AleksaHeler/Constant-current-load/README.md

# Constant-current-load
Constant current load circuit with 0-2A adjustment

## Finding a design and adjusting it
For some time I was looking to make a constant current loads to test some pc power supplies I converted to bench power supplies. I found some designs but had various results and nothing seemed to be stable and reliable enough. The main problem was usually the initial current surge was too high and power supplies considered it a short circuit and switched off. Another obstacle was I didn't have an oscilloscope, but I recently got one [JYETech DSO150 Digital Oscilloscope](https://www.banggood.com/Original-JYETech-Assembled-DSO-SHELL-DSO150-Digital-Oscilloscope-Module-9V-p-1211151.html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). Also I came across this thread and this reply on [eevblog.com](https://www.eevblog.com/forum/beginners/a-load-off-my-mnd/msg2151265/#msg2151265), and it seemed promising:
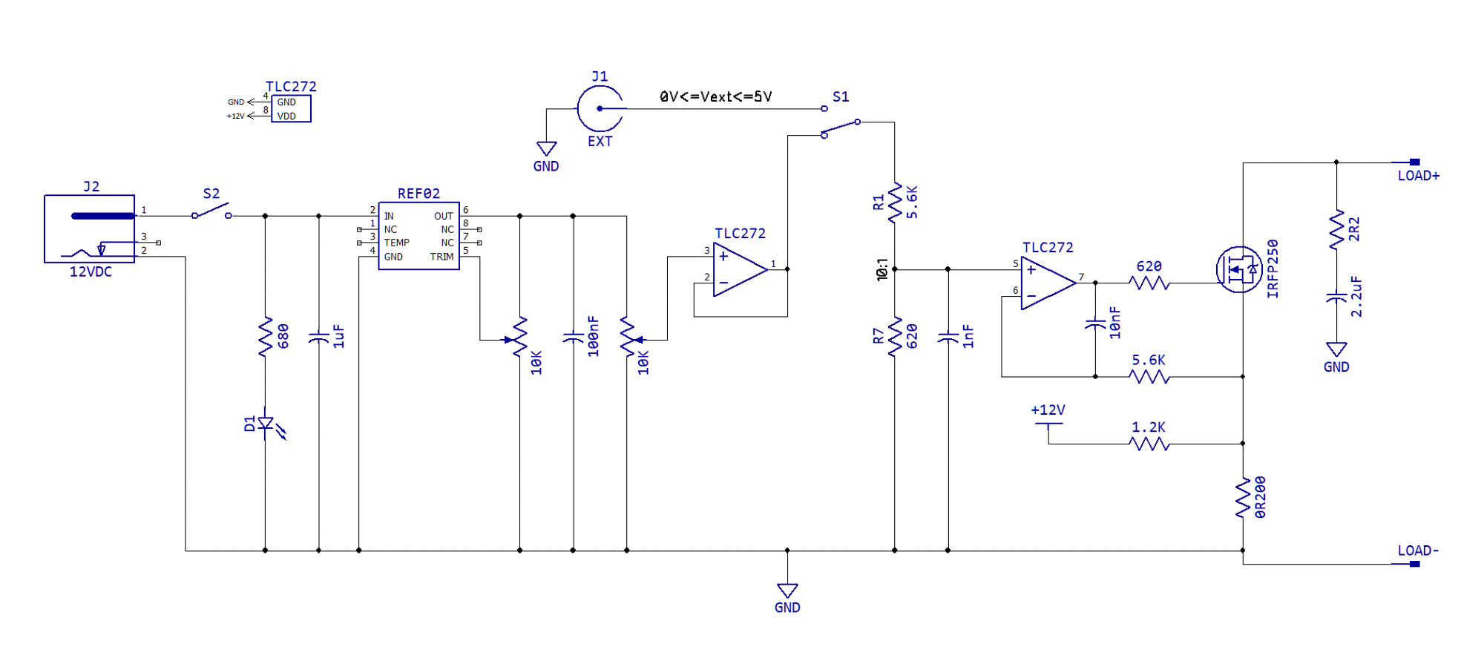
[picture p1: images/eevblog_schematic.jpg]
<br>  
<br> So i changed some things on this schematic to adjust to components I already had and got this:
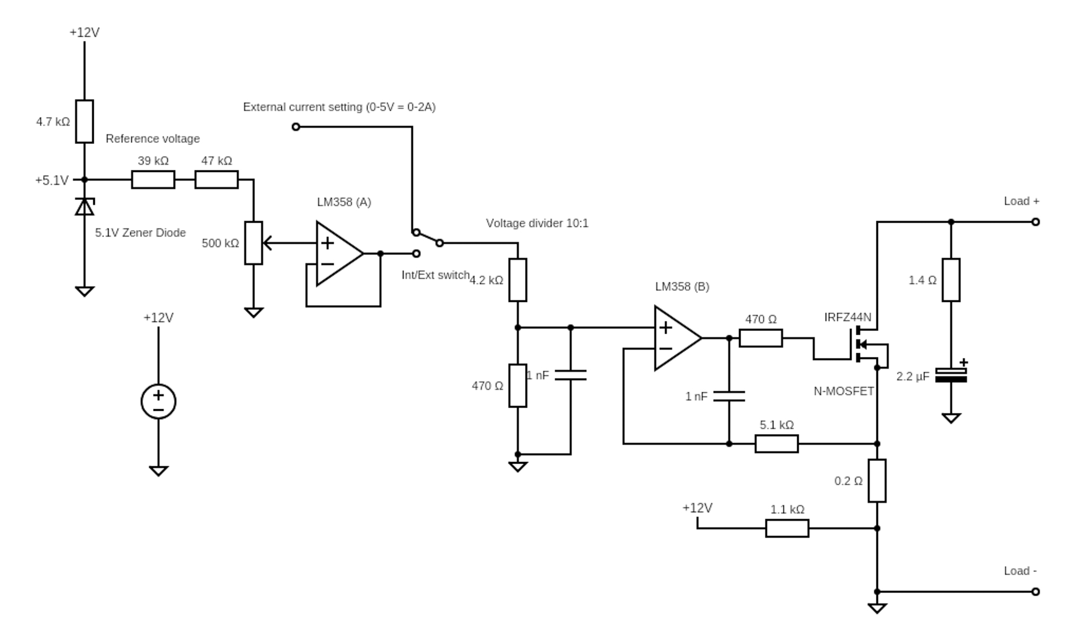
[picture p2: images/my_schematic.jpg]
<br>  

## Prototype and testing
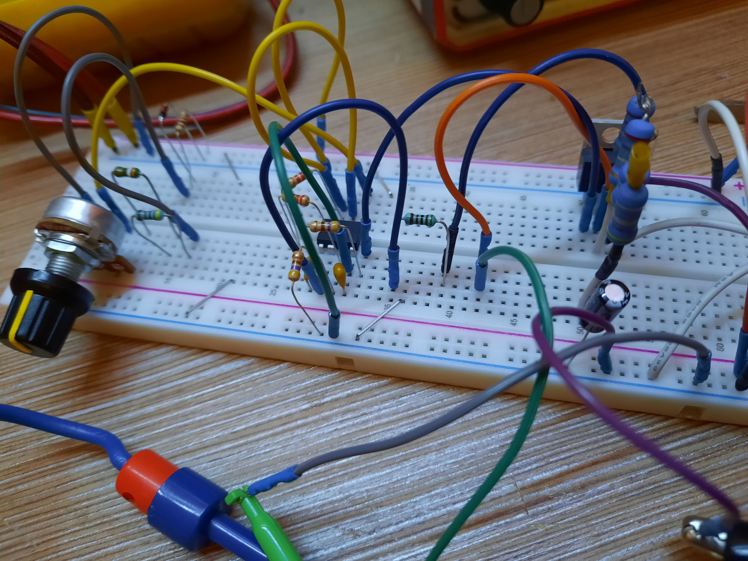
[picture p3: images/breadboard.jpg]
After I got the circuit planed out I started to assemble it all on a breadboard 
<br> Not much to say here but to show some pictures:
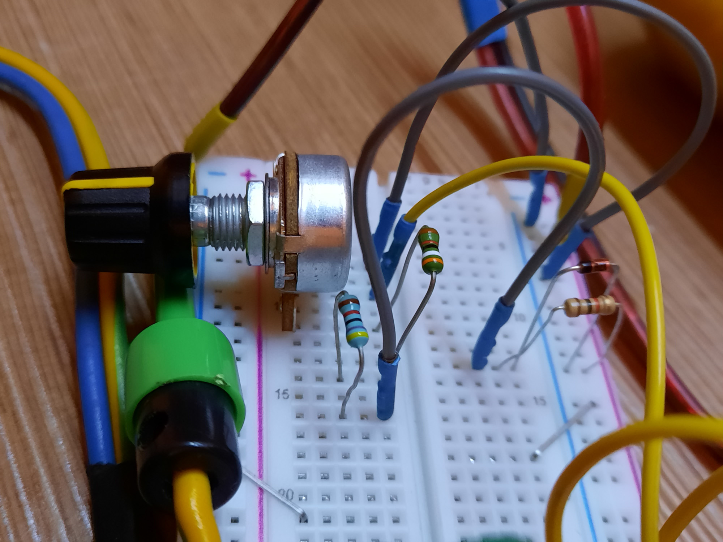
[picture p4: images/breadboard_pot.jpg]
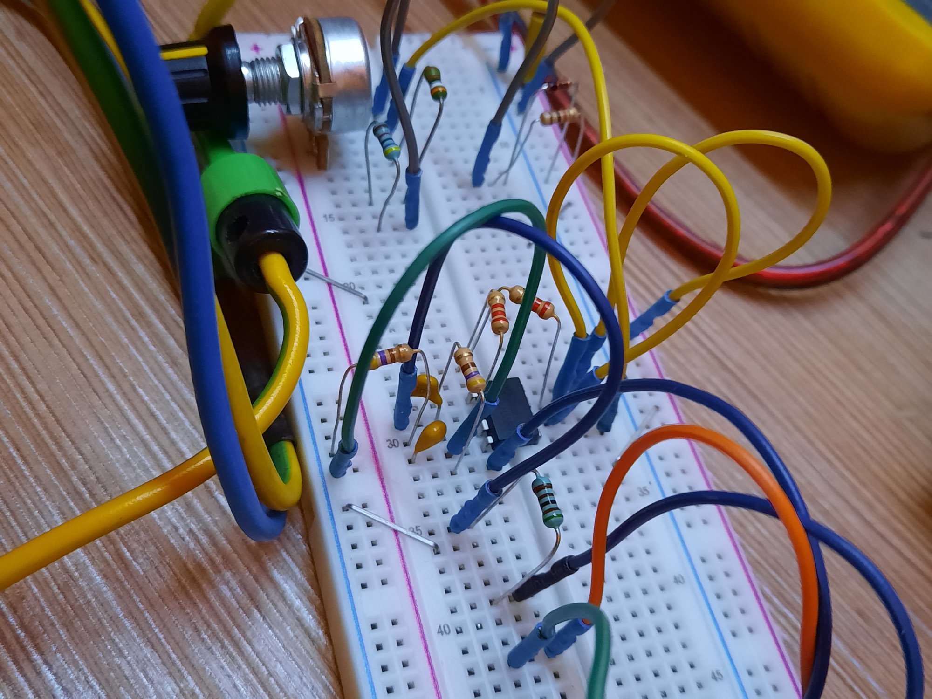
[picture p5: images/breadboard_opamp.jpg]
<br> 
<br> Next step was testing, and I tested how much power does the circuit consume, and it was about 20mA at 12V which is 0.24W both while idle and while sinking a 1A load on 5V.
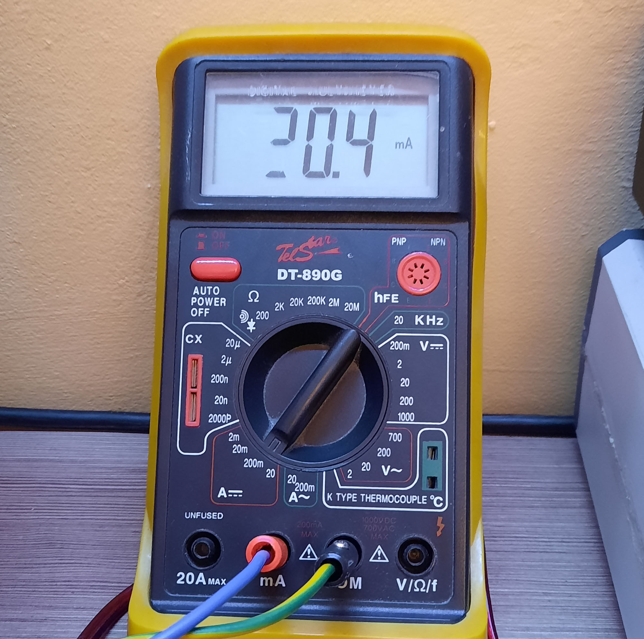
[picture p6: images/meter_idle.jpg]
<br> 
<br> Another thing I tested is will the current be same at different voltages, and it was 0.25A both on 5V and on 12V without changing anything else.
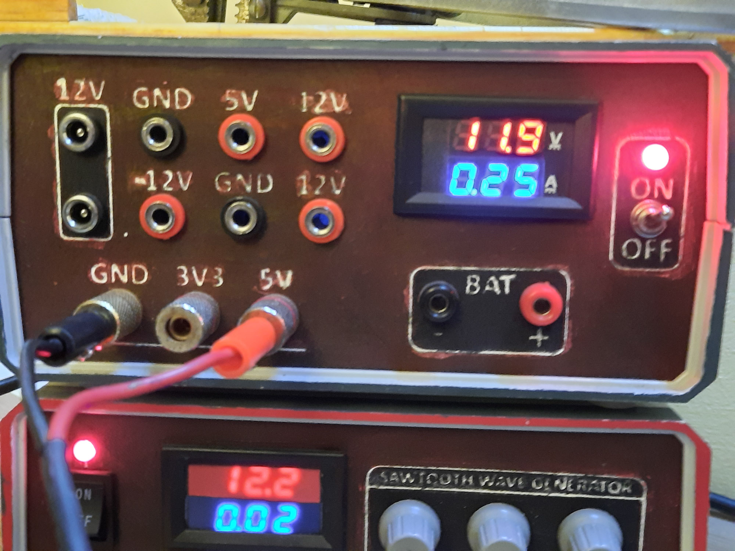
[picture p7: images/load_5V_0.25A.jpg]
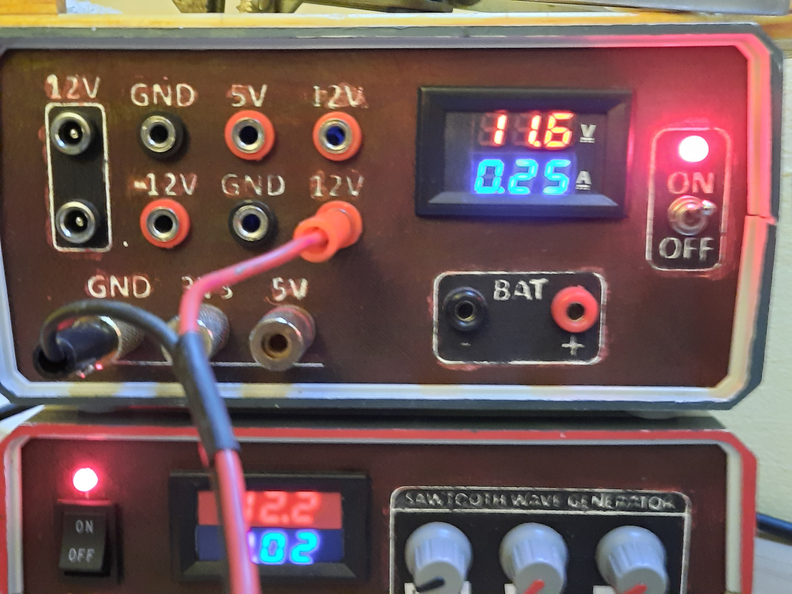
[picture p8: images/load_12V_0.25A.jpg]
<br>  
<br> Final thing, which I was most worried about was initial current surge. The 1nF capacitor on output of second opamp is to prevent that spike, and after testing with 1nF, 10nf and 100nF caps I found the 1nF worked the best and kept it.
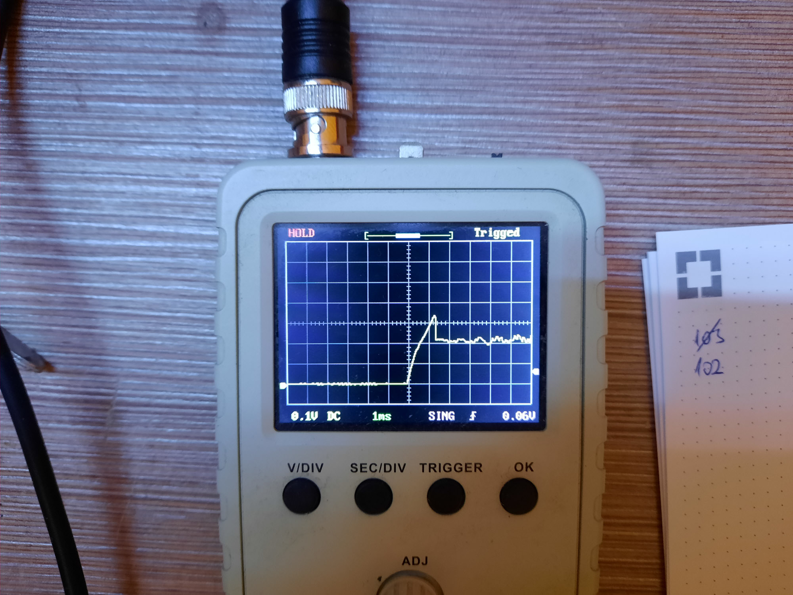
[picture p9: images/osc_cap_102.jpg]
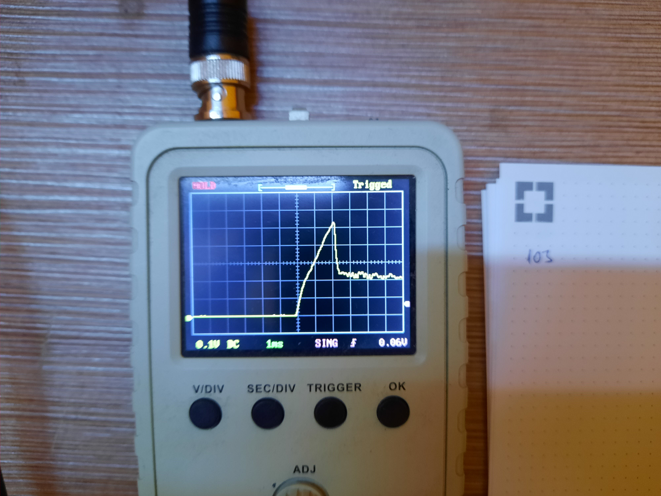
[picture p10: images/osc_cap_103.jpg]
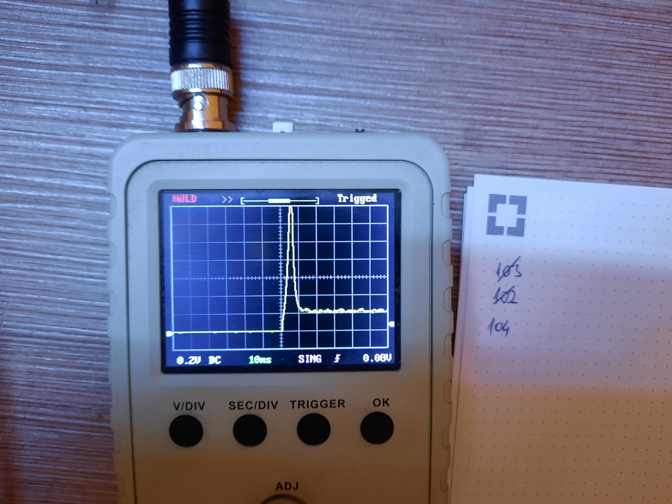
[picture p11: images/osc_cap_104.jpg]
<br>   
<br> Also I just recorded spikes for different currents, here you can see 0.5A, 1A, 1.5A and 2A:
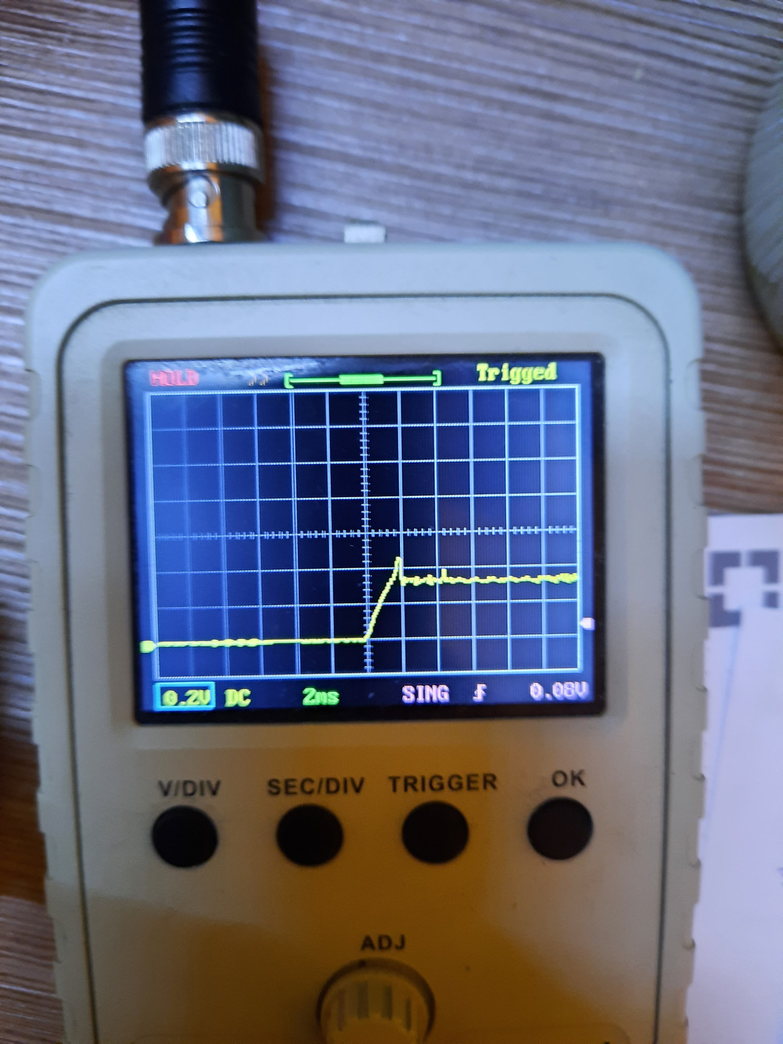
[picture p12: images/osc_1.5A.jpg]
<br>    

## Additional components
I added a heatsink from an old graphics card and an 80mm fan for cooling, and also add a BNC connector for external current setting, useful in future for plotting stuff or something. 

## Building it
I designed an enclosure for 3D printing
<br>
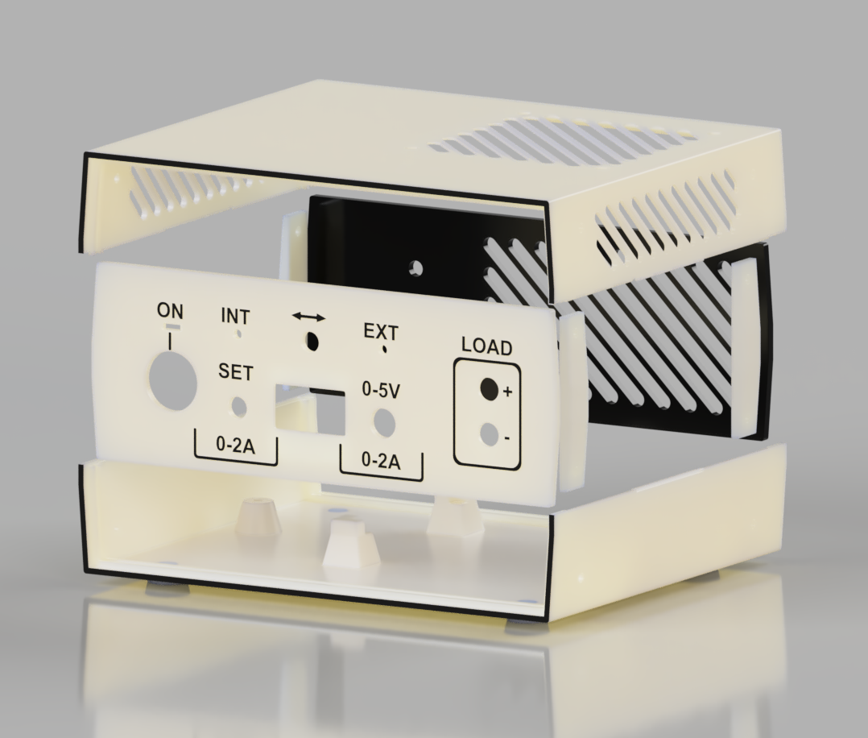
[picture p13: images/cc_load_render.png]


## Final results
TODO: Final pictures, another testing, overheating testing
