AleksaHeler/Constant-current-load/images/breadboard_mosfet.jpg

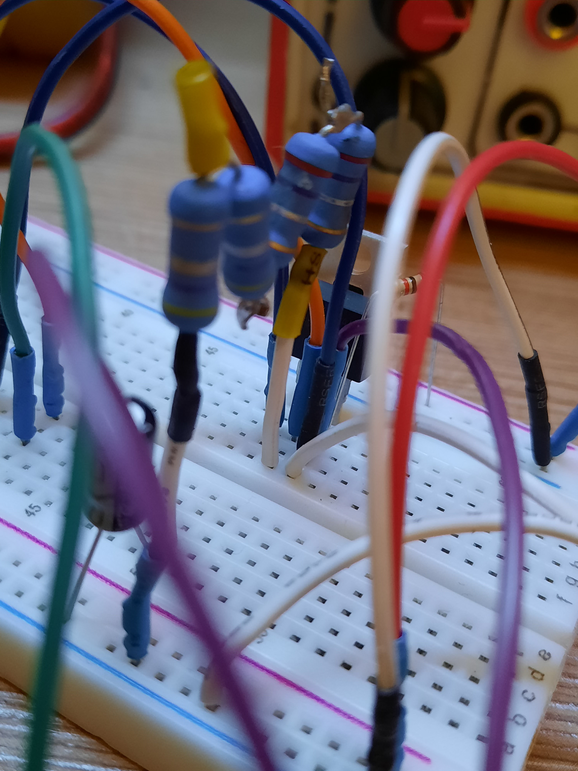
images/breadboard_mosfet.jpg
