AleksaHeler/Constant-current-load/images/meter_1A.jpg

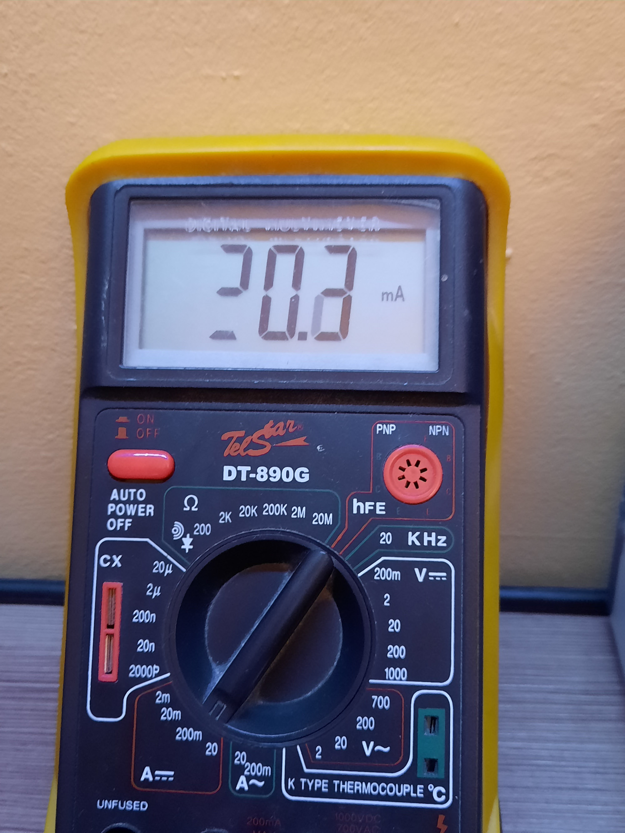
images/meter_1A.jpg
